hu-eeg-project/EEG-project/docs/title-eindrapport.org

#+LATEX: \pagestyle{fancy}
#+LATEX: \fancyhf{}
#+LATEX: \rhead{\theauthor}
#+LATEX: \lhead{\thetitle}
#+LATEX: \cfoot{\thepage}

#+LATEX: \begin{document}

#+LATEX: \begin{titlepage}
#+LATEX: \centering
#+LATEX: \vspace*{0.5 cm}
#+LATEX: \includegraphics[scale = 0.2]{./images/hu-logo.jpg}\\[1.0 cm]
#+LATEX: \textsc{\LARGE Hogeschool Utrecht\newline\newline Technische Informatica}\\[1.0 cm]
#+LATEX: \rule{\linewidth}{0.2 mm} \\[0.4 cm]
#+LATEX: { \LARGE \bfseries Mens-machine interactie door middel van EEG}\\
#+LATEX: { \large \bfseries Eindrapport}\\
#+LATEX: \rule{\linewidth}{0.2 mm} \\[1.5 cm]

#+LATEX: \begin{minipage}{0.4\textwidth}
#+LATEX: \begin{flushleft} \large
#+LATEX: \emph{Projectbegeleider:}\\
#+LATEX: Jorn Bunk\\
#+LATEX: \end{flushleft}
#+LATEX: \end{minipage}~
#+LATEX: \begin{minipage}{0.4\textwidth}

#+LATEX: \begin{flushright} \large
#+LATEX: \emph{Gemaakt Door:} \\
#+LATEX: Stefan de Beer\\
#+LATEX: Paul Ettema\\
#+LATEX: \end{flushright}

#+LATEX: \end{minipage}\\[2 cm]
#+LATEX: \end{titlepage}
