hu-eeg-project/EEG-project/docs/images/messy_p300_plot.png

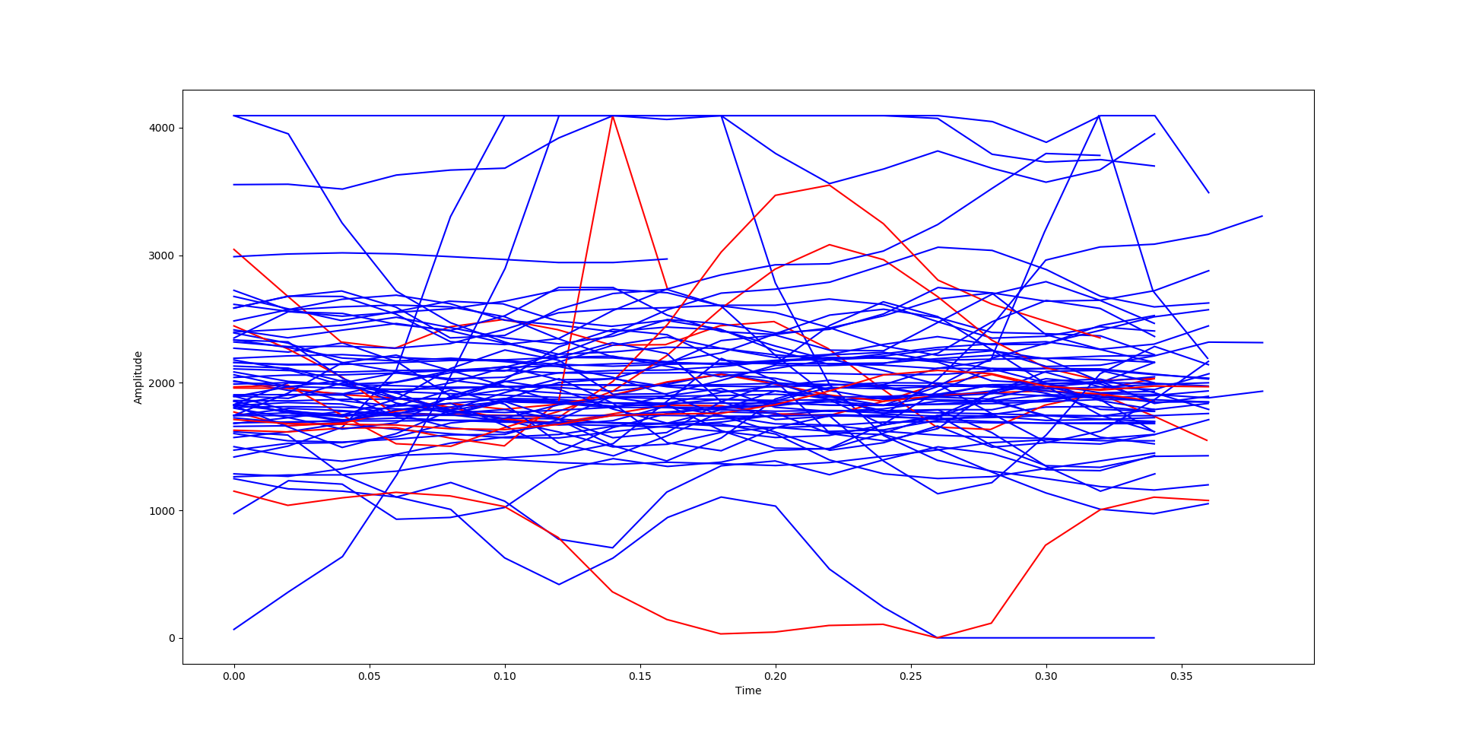
docs/images/messy_p300_plot.png
