hu-eeg-project/EEG-project/docs/images/10-20-5-parts.png

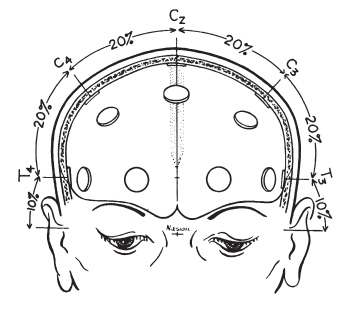
docs/images/10-20-5-parts.png
