hu-eeg-project/EEG-project/src/pc-parser/src/main.cc

/*
 * \file main.cc
 * \brief
 * \author kasumi
 * \copyright Copyright (c) 2018, kasumi
 * \license See LICENSE
 */

#include <stdio.h>
#include <unistd.h>

#include "cmdline.h"

#include "serial.hh"
#include "eeg-graph.hh"
#include "rolling-array.hh"
#include "wave-generator.hh"
#include "eeg-data-decoding.hh"
#include "display-square.hh"
#include "display-keyboard.hh"
#include "data-threads.hh"

#include <thread>
#include <math.h>
#include <time.h>
#include <termios.h>
#include <time.h>
#include <chrono>
#include <iostream>
#include <sstream>
#include <fstream>
#include <sys/types.h>
#include <sys/stat.h>
#include <dirent.h>
#include <memory>
#include <atomic>

#define NUMBER_OF_POINTS 100
#define FRAME_DURATION 3

/**
 * \brief Gets the time and date as string
 * \param with_counter Append a counter at the end of the string or not
 */
std::string getTimeAndDate(bool with_counter = true)
{
    time_t rawtime;
    struct tm* timeinfo;
    char buffer[128];
    static int counter = 1;

    time (&rawtime);
    timeinfo = localtime(&rawtime);

    strftime(buffer, sizeof(buffer), "%Y-%m-%d_%H:%M:%S", timeinfo);
    if (with_counter) return std::string(buffer) +
                          "_" +
                          std::to_string(counter++);
    return std::string(buffer);
}

/**
 * \brief The main entry point of the program
 * \param argc The amount of arguments
 * \param argv The arguments of the program
 */
int main(int argc, char* argv[])
{
    gengetopt_args_info config;
    if (cmdline_parser(argc, argv, &config) != 0) {
        exit(1);
    }

    FrequencyFilter_t filter = {0};
    Frequency_t* frequencies = NULL;

    std::unique_ptr<Display> display;

    bool filtering = false;

    int ay_min, ay_max;
    int threshold;
    int surface_calc;

    if (config.serial_flag) {
        if (config.verbose_flag) printf("Using Serial as data source.\n");
    } else if (config.generator_flag) {
        if (config.verbose_flag) printf("Using Generator as data source.\n");
        if (config.frequency_given != config.amplitude_given) {
            printf("Same amount of frequencies and amplitudes needed!\n");
            exit(1);
        }

        frequencies = new Frequency_t[config.frequency_given];
        if (!frequencies) {
            printf("Failed to allocate memory for frequencies.\n");
            exit(1);
        }

        for (int i = 0; i < config.frequency_given; i++) {
            frequencies[i] = {config.amplitude_arg[i],
                              (uint16_t) config.frequency_arg[i]};
        }

        if(config.filter_frequency_given){
            filtering = true;
            for(int i = 0;i<config.filter_frequency_given;i++){
                filter.frequencies = config.filter_frequency_arg;
            }
            filter.len = config.filter_frequency_given;
        }
        if(config.hp_cutoff_given){
            filtering = true;
            filter.hp_cutoff = config.hp_cutoff_arg;
        }
        if(config.lp_cutoff_given){
            filtering = true;
            filter.lp_cutoff = config.lp_cutoff_arg;
        }

    } else {
        printf("No data source!\n");
        exit(1);
    }

    if(config.ay_range_given == 2){
        ay_min = config.ay_range_arg[0];
        ay_max = config.ay_range_arg[1];
    }else{
        ay_min = -1000;
        ay_max = 1000;
    }
    if (config.threshold_given) {
        threshold = config.threshold_arg;
    } else {
        threshold = (ay_max + ay_min) / 2;
    }
    if (config.verbose_flag) {
        printf("Range: %i <-> %i Threshold: %i\n", ay_min, ay_max, threshold);
    }

    EEGGraph eeg(&argc, argv, ay_min, ay_max, config.display_fft_flag);
    RollingArray<Double_t> data_array(NUMBER_OF_POINTS);
    RollingArray<Double_t> time_array(NUMBER_OF_POINTS);
    ArrayPair<RollingArray<Double_t>, RollingArray<Double_t>> data(data_array,
                                                                   time_array);

    std::string start_time_string = getTimeAndDate(false);

    if (config.p300_given) {
        if (config.verbose_flag) printf("Creating P300 display\n");

        switch (config.p300_arg)
        {
            case 1:
                display = std::make_unique<DisplaySquare>();
                break;
            case 2:
                display = std::make_unique<DisplayKeyboard>(1.f, 10);
                break;
            case 3:
                display = std::make_unique<DisplaySquare>(true);
                break;
            default:
                if (config.verbose_flag) printf("Invalid p300 display!\n");
                exit(-1);
        }

        DIR* d = opendir(start_time_string.c_str());
        if (d) closedir(d);
        else {
            int r = mkdir(start_time_string.c_str(),
                          S_IRWXU | S_IRGRP | S_IXGRP | S_IROTH | S_IXOTH);
            if (r == -1) {
                printf("Failed to create directory for logs!\n");
                exit(-1);
            }
        }
    }
    std::atomic<bool> close_thread(0);
    std::thread data_thread;
    if (config.serial_flag) {
        SerialConfig_t sConfig = {std::string(config.interface_arg), B115200};
        data_thread = std::thread(serialThread, &data, &close_thread);
    } else {
        data_thread = std::thread(testThread,
                                  &data,
                                  NUMBER_OF_POINTS / FRAME_DURATION,
                                  frequencies,
                                  config.frequency_given,
                                  &close_thread);
    }

    Double_t data_array_copy[NUMBER_OF_POINTS];
    Double_t time_array_copy[NUMBER_OF_POINTS];

    RollingArray<Double_t> filtered_data(NUMBER_OF_POINTS);
    RollingArray<Double_t> filtered_time(NUMBER_OF_POINTS);

    std::ofstream file;
    std::string filename;
    double last_time;

    bool recording = false;
    record_data_t record_data;
    bool looping = true;

    while (looping) {
        data.lock();
        int size = data.array1.getSize();
        for (int i = 0; i < size; i++) {
            data_array_copy[i] = data.array1[i];
            time_array_copy[i] = data.array2[i];
        }
        data.unlock();

        if (display) {
            // If the display is running check if close was requested and check
            // if needed to record the data currently being measured.
            looping = display->update();
            record_data = display->recording();
            if (record_data.recording) {
                if (!recording) {
                    // Create a file if a new recording is started with time and
                    // date
                    recording = true;
                    filename = start_time_string + "/"
                             + getTimeAndDate() + ".eeg";

                    file.open(filename);
                    if (!file.is_open()) {
                        printf("Failed to create file!\n");
                    }

                    // Store metadata of the recording into the new file
                    file << "metadata," << record_data.metadata << std::endl;

                    // Calculate threshold for surface calculation
                    threshold = 0;
                    for (int i = 0; i < size; i++) {
                        threshold += data_array_copy[i];
                    }
                    if (size > 0) threshold = threshold / size;
                    if (config.verbose_flag) printf("Threshold: %i\n",
                                                    threshold);

                    surface_calc = 0;
                    last_time = time_array_copy[size - 1];
                }

                // Put the current data and time into the file if recording
                for (int i = 0; i < size; i++) {
                    if (time_array_copy[i] > last_time) {
                        last_time = time_array_copy[i];
                        file << time_array_copy[i] << ","
                             << data_array_copy[i] << std::endl;

                        // Calculate surface in relation to the threshold
                        surface_calc += data_array_copy[i] - threshold;
                    }
                }

            } else {
                if (recording) {
                    // Close file if not recording anymore
                    recording = false;
                    file.close();
                    if (config.verbose_flag) {
                        printf("Wrote P300 file [%s].\n", filename.c_str());
                        printf("Graph Surface [%i].\n", surface_calc);
                    }
                }
            }
        }
        if(filtering){
            // Filter data and then update the EEG Graph
            eeg.filter_freq(size,
                            time_array_copy,
                            data_array_copy,
                            &filtered_data,
                            &filtered_time,
                            filter);
            eeg.update(size, filtered_time.getData(), filtered_data.getData());
        }else{
            // Update the EEG Graph
            eeg.update(size, time_array_copy, data_array_copy);
        }

        // Sleep for 16 ms to get around 60 fps max
        usleep(1000 * 16);
    }
    // Request close_thread from the other threads that are spawned and join
    // back with them
    close_thread = true;
    data_thread.join();

    // Delete frequencies and p300 display if they were created
    if (frequencies) delete[] frequencies;
    if (display) display.reset(nullptr);

    return 0;
}
