hu-eeg-project/EEG-project/src/openeeg/main/main.c

#include "freertos/FreeRTOS.h"
#include "esp_system.h"
#include "esp_event.h"
#include "esp_event_loop.h"
#include "nvs_flash.h"
#include "esp_timer.h"
#include "driver/adc.h"

esp_err_t event_handler(void *ctx, system_event_t *event)
{
    return ESP_OK;
}

void app_main(void)
{
    nvs_flash_init();
    ESP_ERROR_CHECK(esp_event_loop_init(event_handler, NULL));

    adc1_config_width(ADC_WIDTH_BIT_12);
    adc1_config_channel_atten(ADC1_CHANNEL_0, ADC_ATTEN_DB_11);

    uint64_t last_specifier = esp_timer_get_time();
    printf("b:0\n"); // Data to the PC is not batched, but a continuous stream.

    while (true) {

        int val = adc1_get_raw(ADC1_CHANNEL_0);

        printf("d:%i\n", val);

        if (esp_timer_get_time() - last_specifier > 1000000) {
            last_specifier = esp_timer_get_time();
            printf("b:0\n"); // Resend batch specifier every second.
        }
        // Sample every 20 ms. Sampling more often than this will introduce noise in data.
        vTaskDelay(20 / portTICK_PERIOD_MS);
    }
}
