hu-eeg-project/EEG-project/(commit log)

2018-09-26 added planning, changed the research questions and fixed some spelling mistakes
    [planning.ods]
2018-09-26 Updated attachement B to reflect the new deelvragen.
2018-10-05 Added ruis and some other misc things.
    [planning.ods]
2018-10-05 Updated planning.
    [planning.ods]
2018-10-08 Added first draft of circuitry for testing amplifications / ADC.
    [prototype-channel.kicad_pcb, prototype-channel.sch]
2018-10-12 Added some explenation to modEEGamp circuit
2018-10-29 Added drivers for reading data from the Force Trainer 2
2018-10-30 Made graph render correctly from rolling array.
    [eeg-graph.cc, main.cc]
2018-10-30 Added noise functionality to wave generator
    [main.cc, wave-generator.cc]
2018-11-05 Fixed the Force Trainer problem and added filter for frequencies
    [eeg-graph.cc, main.cc, serial.cc]
2018-11-14 Added decoder for openEEG and fixed indentation
    [eeg-data-decoding.cc, main.cc]
2018-11-28 Fixed multiple batch commandos and added some extra fft detection code.
    [eeg-data-decoding.cc, eeg-graph.cc]
2018-12-03 Added frequency filter to EEG
2018-12-05 Removed terminal output and fixed error handling
    [display.cc, eeg-data-decoding.cc]
2018-12-07 Y axis range can now be set though command line parameters
2018-12-11 Added a bit to werken met de hardware in eindrapport
2018-12-13 P300 window now closes when any button is pressed
2018-12-14 fixed the data threads
2018-12-17 Added schematic how the OpenEEG is connected to our esp32.
2018-12-18 Fixed ADC being read too fast.
    [main.c]
2018-12-18 Plotter now shares y axis.
2019-01-02 Worked eind eindverslag: de P300 detecteren
2019-01-03 Worked on eindrapport: Werken met de hardware and Ruis in het signaal.
2019-01-23 Fixed typo in main.c
    [main.c]
